0w5/tt_sky26a_analog_prj/(commit log)

2026-05-12 Update info.yaml
    update pin description
2026-05-12 upload final design
    [CNTDIG_v1.sch, DFF3V3_v1.sch, DSMANA_v1.sch, LATARRY_v1.sch, LVSHFTH2L_v1.sch, LVSHFTL2H_v1.sch, PLSGEN_v1.sch, RC10b_v1.sch]
